Shadesmar467/MicroMouse-2024/hardware/bare_mouse/MicroMouseDoc.docx

PCB Design:

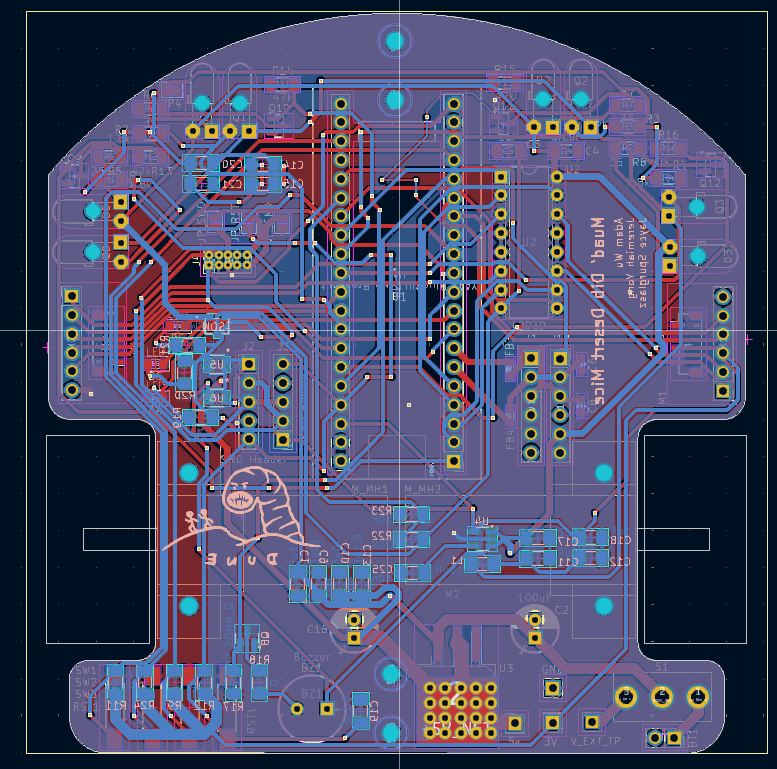
[picture p1: figure]

KiCad Project Link:

https://drive.google.com/file/d/1nM1WBd9EF2FeSmfahikznsvhkG3Da5eu/view?usp=sharing
