Shadesmar467/MicroMouse-2024/firmware/CHOAM/Core/Src/main.c

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
/* Includes ------------------------------------------------------------------*/
#include "main.h"

/* USER CODE BEGIN Includes */
// hardware includes
#include "adc_manager.h"
#include "distance.h"
#include "motors.h"
#include "values.h"
#include "movement.h"
#include "PID.h"

// software integration includes
#include "floodfill_includes/definitions.h"
#include "floodfill_includes/mouseFunctions.h"
#include "floodfill_includes/mazeFunctions.h"
#include "floodfill_includes/utilityFunctions.h"
#include "floodfill_includes/floodFill.h"

/* USER CODE END Includes */

ADC_HandleTypeDef hadc1;

TIM_HandleTypeDef htim2;
TIM_HandleTypeDef htim3;
TIM_HandleTypeDef htim4;

/* USER CODE BEGIN PV */
int dis_FL;
int dis_FR;
int dis_SL;
int dis_SR;

int debug1 = 0;
int debug2 = 0;
int debug3 = 0;
int debug4;
int debug5;
int debug6;
int debug7;
int debug8;
int debug9;

int rotating;

float prev_error_l, prev_error_r, prev_encoder_error;
float currentEncDist;
float error_integral = 0;
Mouse mouse;

/* USER CODE END PV */

void SystemClock_Config(void);
static void MX_GPIO_Init(void);
static void MX_TIM2_Init(void);
static void MX_ADC1_Init(void);
static void MX_TIM3_Init(void);
static void MX_TIM4_Init(void);
/* USER CODE BEGIN 0 */

/*ir var inits*/


//int mouseSpeedL = addVoltage + biasVoltageL;
//int mouseSpeedR = addVoltage + biasVoltageR;

int mouseSpeedL = CRUISE_SPEED;
int mouseSpeedR = CRUISE_SPEED;

uint16_t encL = 0, encR = 0; //counter for left and right encoder value
uint16_t prevEncL = 0, prevEncR = 0; // counter for previous left and right encoder values
float encLmm, encRmm;	// distance traveled in mm
int16_t dL, dR;		// change in ticks traveled since last update
float encrIdeal = 0, enclIdeal = 0;

void HAL_TIM_IC_CaptureCallback(TIM_HandleTypeDef *htim) {
 //left encoder timer
	if (htim->Instance == TIM3){
		encL = __HAL_TIM_GET_COUNTER(htim);
		dL = (int16_t)(prevEncL - encL);
		encLmm += dL / tickConvertL;		// every 5.74125 ticks is 1 mm
		prevEncL = encL;
	}

	if (htim->Instance == TIM4) {
		encR = __HAL_TIM_GET_COUNTER(htim);
		dR = (int16_t)(prevEncR - encR);
		encRmm += dR / tickConvertR;	//every 2.90833 ticks is 1mm
		prevEncR = encR;
	}
}
void measure_ir(){
	float raw_FL = measure_dist(DIST_FL);
	float raw_FR = measure_dist(DIST_FR);
	float raw_SL = measure_dist(DIST_SL);
	float raw_SR = measure_dist(DIST_SR);

	dis_FL = (((raw_FL - z_FL)/(loc_FL - z_FL)) * NOM_F) + 200; //raw
	dis_FR = (((raw_FR - z_FR)/(loc_FR - z_FR)) * NOM_F) + 200; //raw
	dis_SL = (((raw_SL - z_SL)/(loc_SL - z_SL)) * NOM_S) + 130; //raw
	dis_SR = (((raw_SR - z_SR)/(loc_SR - z_SR)) * .5 * NOM_S) + 105; //raw
}
/* USER CODE END 0 */

/**
  * @brief  The application entry point.
  * @retval int
  */
int main(void)
{

  /* MCU Configuration--------------------------------------------------------*/

  /* Reset of all peripherals, Initializes the Flash interface and the Systick. */
	HAL_Init();

  /* Configure the system clock */
  SystemClock_Config();

  /* USER CODE BEGIN SysInit */
  MX_GPIO_Init();
  MX_TIM2_Init();

  /* USER CODE END SysInit */

  /* Initialize all configured peripherals */
  MX_GPIO_Init();
  MX_TIM2_Init();
  MX_ADC1_Init();
  MX_TIM3_Init();
  MX_TIM4_Init();
  /* USER CODE BEGIN 2 */

  //start motors
  HAL_TIM_PWM_Start(&htim2, TIM_CHANNEL_3);
  HAL_TIM_PWM_Start(&htim2, TIM_CHANNEL_4);

  //start left encoder
  HAL_TIM_Encoder_Start_IT(&htim3, TIM_CHANNEL_ALL);
  HAL_TIM_Encoder_Start_IT(&htim4, TIM_CHANNEL_ALL);

  HAL_TIM_Base_Start_IT(&htim2);

  Mouse myMouse;
  Maze myMaze;

  /* USER CODE END 2 */

  /* Infinite loop */
  /* USER CODE BEGIN WHILE */

  HAL_Delay(500);
  HAL_GPIO_TogglePin(GPIOC, GPIO_PIN_13);

  while (dis_FL > 180){
  }
  while (1){

  }

  HAL_GPIO_TogglePin(GPIOC, GPIO_PIN_13);
  HAL_Delay(1500);

  init_maze(&myMaze, &myMouse); //hard-code the boundary walls
  setGoalPos(goal1, &myMaze);
  scan_walls(&myMaze, &myMouse);

  while (goToPos(1, &myMaze, &myMouse)) {
	  move_dist(185);
	  updateMousePos(&myMouse);
  }


    /* USER CODE END WHILE */

}

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
/* USER CODE BEGIN 4 */
void HAL_TIM_PeriodElapsedCallback(TIM_HandleTypeDef* htim) {
	debug1 = wallDetectFront();
	debug2 = wallDetectRight();
	debug3 = wallDetectLeft();

	//turn off IR while turning
	debug4 = measure_dist(DIST_FL);
	debug5 = measure_dist(DIST_FR);
	debug6 = measure_dist(DIST_SL);
	debug7 = measure_dist(DIST_SR);
//
	measure_ir();
	PID();

}
/* USER CODE END 4 */
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
