Shadesmar467/MicroMouse-2024/firmware/CHOAM/CHOAM.ioc

Mcu.UserName=STM32F103C8Tx
PA0-WKUP.GPIO_Label=BLE_STATE
PA0-WKUP.Signal=GPIO_Output
PA1.Signal=ADCx_IN1
PA10.Signal=USART1_RX
PA11.GPIO_Label=LED_RED
PA11.Signal=GPIO_Output
PA12.GPIO_Label=LED_BLUE
PA12.Signal=GPIO_Output
PA13.Signal=SYS_JTMS-SWDIO
PA14.Signal=SYS_JTCK-SWCLK
PA15.GPIO_Label=LED_GREEN
PA15.Signal=GPIO_Output
PA2.GPIO_Label=MR_PWM
PA2.Signal=S_TIM2_CH3
PA3.GPIO_Label=ML_PWM
PA3.Signal=S_TIM2_CH4
PA4.GPIO_Label=REC_FR
PA4.Signal=ADCx_IN4
PA5.GPIO_Label=REC_SR
PA5.Signal=ADCx_IN5
PA6.GPIO_Label=ML_ENC_A
PA6.Signal=S_TIM3_CH1
PA7.GPIO_Label=ML_ENC_B
PA7.Signal=S_TIM3_CH2
PA8.GPIO_Label=ML_FWD
PA8.Signal=GPIO_Output
PA9.Signal=USART1_TX
PB0.GPIO_Label=REC_FL
PB0.Signal=ADCx_IN8
PB1.GPIO_Label=REC_SL
PB1.Signal=ADCx_IN9
PB10.GPIO_Label=EMIT_SR
PB10.Signal=GPIO_Output
PB11.GPIO_Label=EMIT_FL
PB11.Signal=GPIO_Output
PB12.GPIO_Label=EMIT_SL
PB12.Signal=GPIO_Output
PB13.GPIO_Label=MR_FWD
PB13.Signal=GPIO_Output
PB14.GPIO_Label=ML_BWD
PB14.Signal=GPIO_Output
PB15.GPIO_Label=MR_BWD
PB15.Signal=GPIO_Output
PB3.GPIO_Label=SWO
PB3.Signal=GPIO_Output
PB4.Signal=GPIO_Input
PB5.GPIO_Label=EMIT_FR
PB5.Signal=GPIO_Output
PB6.GPIO_Label=MR_ENC_B
PB6.Signal=S_TIM4_CH1
PB7.GPIO_Label=MR_ENC_A
PB7.Signal=S_TIM4_CH2
PB8.GPIO_Label=BUZZER
PB8.Signal=GPIO_Output
PC13-TAMPER-RTC.Signal=GPIO_Output
PC14-OSC32_IN.Signal=GPIO_Input
PD0-OSC_IN.Signal=RCC_OSC_IN
PD1-OSC_OUT.Signal=RCC_OSC_OUT
