Shadesmar467/MicroMouse-2024/firmware/CHOAM/Core/Inc/main.h

#define BLE_STATE_Pin GPIO_PIN_0
#define BLE_STATE_GPIO_Port GPIOA
#define MR_PWM_Pin GPIO_PIN_2
#define MR_PWM_GPIO_Port GPIOA
#define ML_PWM_Pin GPIO_PIN_3
#define ML_PWM_GPIO_Port GPIOA
#define REC_FR_Pin GPIO_PIN_4
#define REC_FR_GPIO_Port GPIOA
#define REC_SR_Pin GPIO_PIN_5
#define REC_SR_GPIO_Port GPIOA
#define ML_ENC_A_Pin GPIO_PIN_6
#define ML_ENC_A_GPIO_Port GPIOA
#define ML_ENC_B_Pin GPIO_PIN_7
#define ML_ENC_B_GPIO_Port GPIOA
#define REC_FL_Pin GPIO_PIN_0
#define REC_FL_GPIO_Port GPIOB
#define REC_SL_Pin GPIO_PIN_1
#define REC_SL_GPIO_Port GPIOB
#define EMIT_SR_Pin GPIO_PIN_10
#define EMIT_SR_GPIO_Port GPIOB
#define EMIT_FL_Pin GPIO_PIN_11
#define EMIT_FL_GPIO_Port GPIOB
#define EMIT_SL_Pin GPIO_PIN_12
#define EMIT_SL_GPIO_Port GPIOB
#define MR_FWD_Pin GPIO_PIN_13
#define MR_FWD_GPIO_Port GPIOB
#define ML_BWD_Pin GPIO_PIN_14
#define ML_BWD_GPIO_Port GPIOB
#define MR_BWD_Pin GPIO_PIN_15
#define MR_BWD_GPIO_Port GPIOB
#define ML_FWD_Pin GPIO_PIN_8
#define ML_FWD_GPIO_Port GPIOA
#define LED_RED_Pin GPIO_PIN_11
#define LED_RED_GPIO_Port GPIOA
#define LED_BLUE_Pin GPIO_PIN_12
#define LED_BLUE_GPIO_Port GPIOA
#define LED_GREEN_Pin GPIO_PIN_15
#define LED_GREEN_GPIO_Port GPIOA
#define SWO_Pin GPIO_PIN_3
#define SWO_GPIO_Port GPIOB
#define EMIT_FR_Pin GPIO_PIN_5
#define EMIT_FR_GPIO_Port GPIOB
#define MR_ENC_B_Pin GPIO_PIN_6
#define MR_ENC_B_GPIO_Port GPIOB
#define MR_ENC_A_Pin GPIO_PIN_7
#define MR_ENC_A_GPIO_Port GPIOB
#define BUZZER_Pin GPIO_PIN_8
#define BUZZER_GPIO_Port GPIOB
