Shadesmar467/MicroMouse-2024/firmware/CHOAM/Core/Inc/PID.h

/*
 * PID.h
 *
 *  Created on: May 25, 2025
 *      Author: adamhwu
 */

#ifndef INC_PID_H_
#define INC_PID_H_

void leftWallPID();

void rightWallPID();

void IR_PID();

void encoder_PID();

void PID();



#endif /* INC_PID_H_ */
