Shadesmar467/MicroMouse-2024/firmware/CHOAM/Core/Src/adc_manager.c

#include "adc_manager.h"
#include "main.h"

void ADC1_Select_CH4(void){
	ADC_ChannelConfTypeDef sConfig = {0};

	sConfig.Channel = ADC_CHANNEL_4;
	sConfig.Rank = ADC_REGULAR_RANK_1;
	sConfig.SamplingTime = ADC_SAMPLETIME_7CYCLES_5;
	if (HAL_ADC_ConfigChannel(&hadc1, &sConfig) != HAL_OK)
	{
		Error_Handler();
	}
}
void ADC1_Select_CH5(void){
	ADC_ChannelConfTypeDef sConfig = {0};

	sConfig.Channel = ADC_CHANNEL_5;
	sConfig.Rank = ADC_REGULAR_RANK_1;
	sConfig.SamplingTime = ADC_SAMPLETIME_7CYCLES_5;
	if (HAL_ADC_ConfigChannel(&hadc1, &sConfig) != HAL_OK)
	{
		Error_Handler();
	}
}
void ADC1_Select_CH8(void){
	ADC_ChannelConfTypeDef sConfig = {0};

	sConfig.Channel = ADC_CHANNEL_8;
	sConfig.Rank = ADC_REGULAR_RANK_1;
	sConfig.SamplingTime = ADC_SAMPLETIME_7CYCLES_5;
	if (HAL_ADC_ConfigChannel(&hadc1, &sConfig) != HAL_OK)
	{
		Error_Handler();
	}
}
void ADC1_Select_CH9(void){
	ADC_ChannelConfTypeDef sConfig = {0};

	sConfig.Channel = ADC_CHANNEL_9;
	sConfig.Rank = ADC_REGULAR_RANK_1;
	sConfig.SamplingTime = ADC_SAMPLETIME_7CYCLES_5;
	if (HAL_ADC_ConfigChannel(&hadc1, &sConfig) != HAL_OK)
	{
		Error_Handler();
	}
}
