Shadesmar467/MicroMouse-2024/(commit log)

2024-11-14 current progres
2024-11-14 fix floodfill to work for empty maze
    [floodFill.hpp]
2024-11-14 fix log messages to be more clear
    [floodFill.hpp]
2024-11-14 functioning getBestCell() but neighborCell() edge case isnt working
2024-11-14 fixed neighborCell() to not give cells blocked by walls
    [utilityFunctions.hpp]
2024-11-14 attempting to fix floodfill, doesnt account for walls currently
    [floodFill.hpp, utilityFunctions.hpp]
2024-11-14 move works, floodfill still broken. Intialization works
    [Main.cpp, utilityFunctions.hpp]
2024-11-21 kicad files added
    [bloo.kicad_pcb, bloo.kicad_sch, bloo.sch]
2024-11-26 initial commit, starting adams pcb
    [bloo.kicad_pcb]
2024-11-26 place footprints and begin routing power section
2024-11-26 same as previous
    [bloo.kicad_pcb]
2024-11-26 checkin changes
    [bloo.kicad_pcb]
2024-11-26 fixing mac windows differences
    [utilityFunctions.hpp]
2024-11-28 jeremiah PCB
    [bloo.kicad_pcb]
2024-11-29 merged adam PCB into master
2024-11-29 LED & switch wiring, mouse lost weight
    [bloo.kicad_pcb]
2024-11-29 initial commit for motor driver and bottom right schematic
2024-11-30 power ORing, SWD header, and other adam sections traced
    [bloo.kicad_pcb, bloo.kicad_sch]
2024-11-30 wiring done
    [bloo.kicad_pcb]
2024-11-30 wiring done for real
    [bloo.kicad_pcb]
2024-12-02 connections complete
    [bloo.kicad_pcb]
2024-12-02 resolved outlines issue and added some vias to fix grounding planes
    [bloo.kicad_pcb]
2024-12-02 oopsies didnt save last time
    [bloo.kicad_pcb]
2024-12-05 changes after meeting with eaton
    [bloo.kicad_pcb]
2024-12-05 errors resolved. JP4 too far away from capacitors?
    [bloo.kicad_pcb]
2024-12-06 added most important part
    [bloo.kicad_pcb]
2024-12-15 added team names to back silkscreen
    [bloo-B_Cu.gbl, bloo-B_Mask.gbs, bloo-B_Paste.gbp, bloo-B_Silkscreen.gbo, bloo-Edge_Cuts.gm1, bloo-F_Cu.gtl, bloo-F_Mask.gts, bloo-F_Paste.gtp]
2024-12-15 created zip file for submission
    [bloo-B_Cu.gbl, bloo-B_Mask.gbs, bloo-B_Paste.gbp, bloo-B_Silkscreen.gbo, bloo-Edge_Cuts.gm1, bloo-F_Cu.gtl, bloo-F_Mask.gts, bloo-F_Paste.gtp]
2025-01-13 zip file for pcb
2025-01-13 add gitignore for kicad metadata files
2025-03-05 solved some errors, created more
    [adc_manager.c, adc_manager.h, distance.c, distance.h, main.c, main.h]
2025-03-12 board blew up
2025-03-27 fixed STLINK (I think), updated code with support for all IR sensors
    [CHOAM.ioc, distance.c, main.c, main.h]
2025-03-29 added motors .c/.h, initialized PWM start
2025-04-02 changed motors, made commenct and small changes
2025-04-04 encoders recording, need to be converted to distance. motors nonfunctional, code seems correct. IR sensors not recording, causes 'target not found, retrying' message to appear. changed motors.c, remo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
    [CHOAM.ioc, main.c, motors.c]
2025-04-06 adam work on motors and encoders
2025-04-09 motors working
2025-04-10 work on IR sensors
2025-04-21 working ir sensors
2025-04-21 fix nested choam directories
    [CHOAM.ioc, adc_manager.c, adc_manager.h, distance.c, distance.h, main.c, main.h, motors.c]
2025-04-26 rough turn functions created (they work based on the assumption that the current encoder calibration is correct)
    [CHOAM.ioc, main.c, main.h, movement.c, movement.h]
2025-05-07 floodfill files improved, reorganized, in stm32cubeide
2025-05-07 removed all unecessary API calls in floodFill, replaced with correct code
    [main.c]
2025-05-09 add floodFill to build, fixed errors
    [main.c, movement.c, values.h]
2025-05-13 Wrote front_straighten, needs calibration and testing
2025-05-15 fixed 17 errors, SCALE values no work
    [distance.c, main.c, values.h]
2025-05-16 fixed SCALE values to use floating point division
    [distance.c, main.c, movement.c, values.h]
2025-05-16 improvements to pid
2025-05-16 workable pid version
2025-05-18 finished pid and walldetect functions
2025-05-19 floodfill files commented, formatted, and fixed
    [adc_manager.h, distance.h]
2025-05-20 troubleshooting pid
2025-05-20 floodfill integrated with PID & movement, pretty bad tho
2025-05-21 jeremiah laptop blew up
    [main.c, movement.c, movement.h, values.h]
2025-05-22 flipped logic of one wall pid
    [movement.c]
2025-05-22 rework/revise jayce code, mouse is drunk
    [main.c, movement.c, movement.h, values.h]
2025-05-23 encoder PID created, not tuned. code cleaned
2025-05-25 working on pid
2025-05-25 working on pid more
